piroot01/DFC77_NTP/documentation/main.tex

\documentclass[12pt]{report}
\usepackage[utf8]{inputenc}
\usepackage{graphicx}
\graphicspath{ {images/} }
\usepackage[a4paper,width=150mm,top=25mm,bottom=25mm]{geometry}
\usepackage{fancyhdr}
\usepackage{titlesec}
\usepackage{amsmath}
\usepackage{listings}

\usepackage[sorting=none,backend=bibtex]{biblatex}
\bibliography{biblio.bib}

\titleformat{\chapter}[block]{\bfseries\Huge}{}{0em}{}
\titleformat{\section}[hang]{\bfseries\Large}{}{1em}{\thesection\enspace}

\pagestyle{fancy}
\fancyhf{}
\fancyhead[R]{DCF77 NTP server}
\fancyhead[L]{\thechapter. Kapitola}
\fancyfoot[C]{\textbf{\thepage}}
\fancypagestyle{plain}{%  the preset of fancyhdr
    \fancyhf{} % clear all header and footer fields
    \fancyfoot[C]{\textbf{\thepage}} % except the center
    \renewcommand{\headrulewidth}{0pt}
    \renewcommand{\footrulewidth}{0pt}}

\title{DCF77 NTP server}

\author{Macháček Tomáš}

\date{\today}

\renewcommand*\contentsname{Obsah}

\begin{document}

\input{titlepage}

\input{affirmation}

\tableofcontents

\chapter{Abstrakt}
\input{abstract}

\chapter{Návrh antény}
\input{chapters/chapter01}

\chapter{Řidicí jednotka antény}
\input{chapters/chapter02}

\chapter{Hlavní jednotka}
\input{chapters/chapter03}

\chapter{Nasazení a obsluha}
\input{chapters/chapter04}

\chapter{Závěr}
\input{conclusion.tex}

\newpage

\chapter{Reference}

\makeatletter
\renewcommand{\chapter}{\@gobbletwo}
\makeatother

\printbibliography

\end{document}
