piroot01/DFC77_NTP/documentation/titlepage.tex

\begin{titlepage}
    \begin{center}
        \vspace*{.06\textheight}

        \LARGE

        \textsc{Gymnázium Jana Keplera}

        \vspace{1.5cm}

        \Large

        \textsc{Závěrečná práce\\
        informatika}

        \vspace{1.5cm}

        \hrule

        \vspace{0.8cm}

        \LARGE
        \textbf{DCF77 NTP server}

        \vspace{0.2cm}
        \Large
        \emph{server poskytující přesný čas}

        \vspace{0.8cm}

        \hrule
        \vspace{2cm}

        \begin{minipage}[c]{0.4\textwidth}
            \begin{flushleft} \large
                \emph{Autor:}\\
                \textsc{Macháček Tomáš}
            \end{flushleft}
        \end{minipage}
        \begin{minipage}[c]{0.4\textwidth}
            \begin{flushright} \large
                \emph{Vedoucí práce:} \\
                \textsc{Bc. Emil Miler}
            \end{flushright}
        \end{minipage}

        \vspace{8cm}

        \today

        \vfill

    \end{center}
\end{titlepage}
