piroot01/DFC77_NTP/documentation/affirmation.tex

\clearpage
\thispagestyle{empty}

\vspace*{\fill}

Prohlašuji, že jsem tuto práci vypracoval samostatně a výhradně s použitím
citovaných pramenů, literatury a dalších odborných zdrojů.

\vspace{0.2cm}

Beru na vědomí, že se na moji práci vztahují práva a povinnosti vyplývající ze
zákona č. 121/2000 Sb., autorského zákona, v platném znění.

\vspace{1.5cm}

\begin{minipage}[t]{0.4\textwidth}
    \begin{flushleft}
        \emph{Dne:}\\
        \vspace{0.5cm}
        \rule[0.5em]{10em}{0.5pt}
    \end{flushleft}
\end{minipage}
\begin{minipage}[t]{0.5\textwidth}
    \begin{flushright}
        \emph{Podpis:} \\
        \vspace{0.5cm}
        \rule[0.5em]{10em}{0.5pt}
    \end{flushright}
\end{minipage}

\vspace{1cm}
