piroot01/DFC77_NTP/codes/hardware/antenna_design/program_outputs/Inductance_to_number_of_threads.pdf

25 | 30 | 35 | 40 | 45
| | Number of threads

0.075

0.100

0.125

0.150

0.175

0.200

0.225

0.250

Inductance (uH)

### Dependence of inductance on the number of threads
