piroot01/DFC77_NTP/codes/hardware/antenna_design/program_outputs/Quality_to_number_of_turns.pdf

25 | 30 | 35 | 40 | 45
| | Number of threads

1375

1400

1425

1450

1475

1500

1525

1550

Quality factor

### Dependence of quality on the number of threads
