piroot01/DFC77_NTP/codes/hardware/antenna_design/program_outputs/Res_resistance_to_number_of_threads.pdf

25 | 30 | 35 | 40 | 45
| | Number of threads

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
Resonance resistivity (kOhm)

Dependence of resonance resistance on the number of threads
