piroot01/DFC77_NTP/documentation/main.pdf

# Gymnázium Jana Keplera

## Závěrečná práce informatika

# DCF77 NTP server

## server poskytující přesný čas

### Autor: Macháček Tomáš

### Vedoucí práce: Bc. Emil Miler

## March 25, 2022

Prohlašuji, že jsem tuto práci vypracoval samostatně a výhradně s použitím citovaných pramenů, literatury a dalších odborných zdrojů.
Beru na vědomí, že se na moji práci vztahují práva a povinnosti vyplývající ze zákona č. 121/2000 Sb., autorského zákona, v platném znění.
Dne: | Podpis:

# Obsah

1 Abstrakt | 3
2 Návrh antény | 4
3 Řidicí jednotka antény | 6
4 Hlavní jednotka | 10
5 Nasazení a obsluha | 14
6 Závěr | 17
7 Reference | 18

2

# Abstrakt

Závěrečná práce pojednává o NTP serveru, který je synchronizovaný s přijímaným časem. Čas je poskytován německým vysílačem DCF77 v Mainflingenu.
První část se zabývá návrhem antény, která je schopna přijímat signál o kmitočtu 77.5 kHz.
V druhé časti práce se rozebírá demodulaci signálu a převod na průmyslovou RS-485 sběrnici. Vše je součástí tzv. anténní jednotky, která obsahuje anténu, demodulační obvod a systém kontrolující kvalitu signálu, což je jedna ze dvou hlavních komponent projektu.
Třetí část se týká hlavní jednotky, ta je zodpovědná za zpracování DCF77 signálu a hostování NTP serveru. Jádrem je Raspberry Zero 2, na které je navržený na zakázku vyrobený HAT. Také rozebírá softwarovou stránku hlavní jednotky a instalací NTP. Též komplikace vzniklé při sestavování.
Poslední pasáž se zaobírá nasazením zařízaní do provozu a posléze připojením klientů na server.

3

# Návrh antény

## 2.1 Teorie

Anténa je zařízení, které slouží k vysílání či přijímání elektromagnetického záření. Každý vodič, jímž prochází střídavý elektrický proud, je vlastně anténa. Geometrickým tvarováním vodiče a přidáváním jistých materiálů (ferity) se upravuje účinnost antény, dle vhodných parametrů.
Každá anténa má své základní parametry. Mezi hlavní patří zisk, rezonanční frekvence, šířka přijímaného pásma a vyzařovací úhel. Podle použití antény se tyto parametry mění. Avšak hlavním parametrem, který nejvíce ovlivňuje vlastnosti, je fyzický tvar antény.
Proto dělíme antény na dipólové, monopólové, složené (Yagi-Uda anténa), smyčkové, kónické a clonové. Každá kategorie představuje jiné spektrum použití. Dipólové se používají pro vysílání TV signálu. Monopólové se používají při příjmu rádiových stanic, vlnové délky řádu desítek centimetrů. Složené jsou vysoce účinné pro širokopásmový příjem, TV i rádia. Smyčkovým anténám se budeme ještě věnovat. Kónické jsou vysoce účiné při vysokých frekvencích. Clonové jsou ideální pro dlouhý dosah.

### 2.1.1 Smyčková anténa

Smyčkové antény jsou velice jednoduché a všestranné. Jejich tvar je rozmanitý, například zaujímají tvar čtvercovitý, trojúhelníkový, kruhový a elipsovitý. Kvůli jednoduchému návrhu a analýze jsou nejvíce rozšířené mezi radioamatéry. Klasifikují se dvou hlavních skupin, elektricky malé a velké. Elektricky malé antény jsou ty, jejichž celková délka (počet závitů znásobený obvodem antény) je menší než desetina vlnové délky. Velké antény svojí délkou odpovídají vlnové délce rezonanční frekvence. Nejvíce se smyčkové antény používají v pásmech dlouhých vln.
Elektricky malé smyčkové antény mají obvykle menší radiační odpor než ztrátový odpor, tedy jsou špatné zářiče, používají se výhradně na příjem signálu. Nejvíce se používají při radiovému příjmu.
Radiační odpor lze zvýšit, a tím pádem zvýšit zisk antény. Nebo prodloužit elektrickou délkou antény či použít jádro z materiálu o vysoké permeabilitě, nejčastěji ferit. Anténa, která je tvořená cívkou navinutou na feritovém jádře, se nazývá feritová smyčková anténa [1].

4

2. Kapitola | DCF77 NTP server

## 2.2 Konstrukce

Pro tento projekt byla zvolena feritová smyčková anténa. Hlavní důvody, proč byl zvolen tento typ antény je kompaktnost, velikost řádu centimetrů, a zisk při dané rezonanční frekvenci. Praktická konstrukce je též jednoduchá. Jedná se vlastně o cívku, která je navinutá na feritové tyčince. S tím úzce souvicí pořizovací cena antény, která je nízká. Nevýhodou bylo shánění feritové tyčinky.
Proto byla nejdříve pořízena tyčinka a podle ní byla vypočítána cívka. Pro výrobu cívky byl použit enamelový drát o průměru 0.2mm. Na polohu cívky, počet závitů a další parametry byl navržen program, o něm později. Cívka se nesmí na tyčce pohybovat, proto je zalitá epoxydem.
Správná funkčnost antény byla zajištěna pomocí následující sestavy. Na generátor funkcí byl připojen volný vodič. Vytvořili jsme jednoduchou anténu. Anténa byla připojena na předzesilovač a poté na osciloskop. Měněním frekvence na generátoru a sledováním úrovně napětí na výstupu zesilovače. Největší úrovně jsme dosáhli na frekveci 77.564 kHz, což je v pořádku, neboť v demodulačním obvodu je použit vysoce účinný krystalový filtr [2]

### 2.2.1 Program pro výpočet antény

Program na výpočet antény se skládá z dvou hlavních částí, kalkulace modelu antény a poté zpracování dat do grafů.
Základem je výpočet radiačního - Rr, ohmického - RL a ztrátového odporu - Rf [3].

Rr = 20π

2

( o

λ

)4
µ

2
ef fN

2

RL =

l
σπdδ

Rf = 2πfµef f

µi
µ

µ0N

2 S
Lr
| (2.1)

Kde o je účinný obvod antény, N je počet závitů cívky, d je průměr vodiče, f je rezonanční frekvence, S je účinný povrch antény a Lr je délka antény.
Pro výpočet pozice cívky na feritové tyčce byly použity Nagaokovy rovnice, které nejblíže odpovídají reálnému modelu antény.
Dále program spočítá rezonanční kondenzátor k dané anténě, jakost antény. Zde je nutno podotknout, že jakost úzce souvisí s ziskem a šířkou přijímaného pásma. Čím užší přijímané pásmo, tím vyšší zisk, avšak anténa je více náchylná na změny tlaku, teplot atd. Právě proto generuje program grafy, které vystihují závislosti a díky nímž je snažší nalézt optimální parametry pro danou anténu.
Na konec program ještě vygeneruje tabulku, v níž jsou zapsány jednotlivé konfigurace antén [4]

5

# Řidicí jednotka antény

## 3.1 Teorie

### 3.1.1 Amplitudová modulace

Amplitudová modulace, zkráceně AM, je nejjednodušší a nejstarší typ modulace. V závislosti na změně modulačního signálu se mění amplituda nosného signálu. Nosná vlna má řádově vyšší frekvenci než modulovaný signál. Fáze a frekvence se u této modulace nemění.

Matematický popis

Pokud nosnou vlnu vyjádříme jako n(t) = N sin (Ωt), kde N je amplituda a Ω je úhlová frekvence, a jednoduchý harmonický signál m(t) = M sin (ωt + ϕ), kde ϕ je fázový posun vůči nosné n(t), pak AM vznikne složením přidáním m(t) k amplitudě nosné N. Dostáváme tedy

y(t) = (N + M sin (ωt + ϕ)) sin (Ωt) | (3.1)

### 3.1.2 DCF77

Označení DCF77 se užívá pro německý dlouhovlnný rádiový vysílač a také jedinou stanici, jíž poskytuje. Nosná frekvence DCF77 je 77500 Hz. Antény stanice se nacházejí v Mainflingenu. Pravidelné a nepřetržité vysílání začalo v roce 1970 [5].

Vysílač

Vysílač má výkon 50 kW, avšak skutečný vyzářený výkon je přibližně 25 kW. K vysílání je použitá všesměrová anténa s kapacitním nástavcem, hlavní anténa je vysoká 150 m, přičemž při údržbách se používá 200 m vysoká záložní. Dosah vysílače je 1500 až 2000 km. V České republice fungoval do roku 1995 velice podobný vysílač OMA [6].

Kódování DCF77

Kódování časové informace je prováděno pulzně šířkovou modulací (základní AM), poklesem amplitudy nosné na 25 % na začátku každé sekundy. Pakliže je puls dlouhý 100ms jedná se logickou 0, 200ms dlouhý je logická 1. Aktualizace přenášené informace je prováděna každou minutu.

6

3. Kapitola | DCF77 NTP server

Přenášejí se tyto informace:

- čas platný pro následující minutu
- datum platné pro následující minutu
- číslo dne v týdnu
- hlášení změny časové zóny 1 hodinu předem (informace o přechodu ze standardního na letní čas nebo opačně)
- časová zóna (je-li aktivní CET nebo CEST)
- hlášení přestupné sekundy 1 hodinu předem
- provoz na normální a rezervní anténu
- zabezpečení přenosu – několik paritních bitů
- od roku 2007 i předpověď počasí

### 3.1.3 RS-485 komunikace

Jedná se o typ komunikace, která se především používá v průmyslových prostředích. Standard 485 je navržen tak, aby umožňoval vytvoření dvouvodičového poloduplexního vícebodového sériového spojení. Vlastně se jedná o značně napěťově posílenou RS-232, což je totéž co RS-485, avšak dosah sběrnice je až 1200 m, oproti 20 m.
Komunikační linka je tvořena dvěma vodiči (označené A a B), na obou koncích jsou kvůli zvýšení odolnosti proti rušení 120Ω rezistory. Maximální přenosová rychlost je 10 Mib/s.
Přenos dat je uskutečněn pomocí 7 nebo 8bitových rámců se startbitem a poté jedním či více stopbity. Vysílač by měl na výstupu při logické 1 (klidový stav linky) generovat na vodiči A napětí −2 V, na vodiči B +2 V, při logické 0 by měl na vodiči A generovat +2 V, na vodiči B −2 V [7].

## 3.2 Zpracování anténní jednotky

Mezi hlavní požadavky anténní jednotky patřila i kompaktnost, proto byl vytvořený, na zakázku, plošný spoj, na nemž jsou uložené všechny komponenty. Dělí se na tři základní sektory, první je zodpovědný za demodulaci signálu, druhý převádí demodulovaný signál na RS-485 sběrnici a poslední vyhodnocuje jakost signálu. Každému sektoru je přiřazen jeden integrovaný obvod.

### 3.2.1 Demodulace DCF77 signálu

Pro tento účel byl zvolen U4224B integrovaný obvod. Jedná se o přijímací obvod, který disponuje demodulací od 40 do 80 kHz, podle zvoleného krystalu. Má velmi vysokou citlivost, takže i v oblatech s vysokým rušením či slabým signálem, je možně anténu dobře naladit.

7

3. Kapitola | DCF77 NTP server

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

### 3.2.2 Převod na RS-485 sběrnici

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

### 3.2.3 Systém pro vyhledávání signálu

Abychom nemuseli při ladění antény čekat dvě minutu na načtení celého bufferu a potom zjišťovali, zda je správný. Nutno podotknou, že anténa je směrová, takže záleží na směru normálového vektoru vůči zdroji, což je anténa DCF77. To ještě ztěžuje situaci ladění. Rychlejší způsob ladění vyžaduje osciloskop. Proto bylo nutné vybavit obvod zařízením, které by v reálném čase sledovalo přijímaný signál a vyhodnocovalo jeho kvalitu.

8

3. Kapitola | DCF77 NTP server

Srdcem je mikrokontrolér PIC, na který je nahraný program, který analyzuje signál z přijímače. Dále jsou na PIC připojeny dvě LED, které fungují jako signalizace. Jedna je zelená, značící, že je obvod napájen a druhá, oranžová, signalizuje kvalitu signálu. A to následujícím způsobem:

Pokud dioda nesvítí, potom je signál zcela vadný. Jakmile se dioda rozbliká, znamená to, že byl přijat validní bit, pakliže se dioda rozbliká rychleji (s vyšší frekvencí), byl přijat další validní bit. Tento postup pokračuje, až dioda svítí, neboli anténa je naladěná. S klesající frekvencí se naopak anténa rozlaďuje. Svitící dioda je zárukou dobrého signálu, nikoliv však dostatečně silného signálu, který je vyžadován NTP.

Program funguje tak, že kontroluje správnou délku signálu, frekvenci, intervaly mezi jednotlivými pulsy, inverzní délku pulzů a minutový puls (prázdný). Pakliže všechny parametry jsou splněny, je bit zaznamenán jako korektní. Tuto proceduru provádí s každým bitem, a to v reálném čase, takže uživatel má aktuální přehled o kvalitě přijímaného signálu a může nalézt místo s nejlepším příjmem.
Deska je osazená pinovou lištou, která slouží k flashování programu, takže je velice snadné aktualizovat program v PICu.

9

# Hlavní jednotka

## 4.1 Teorie

### 4.1.1 Network time protocol

NTP je protokol pro synchronizaci vnitřních hodin počítačů po paketové síti s proměnným zpožděním. Tento protokol zajišťuje, aby všechny počítače v síti měly stejný a přesný čas. Byl obzvláště navržen tak, aby odolával následku proměnlivého zpoždění v doručování paketů.
Počítač, který chce synchronizovat své hodiny, pošle pár dotazů několika NTP serverům a ty mu v odpovědi pošlou svůj, přesný čas. Klient z odpovědí nejprve vyloučí servery se zřejmě nesmyslným časem (s odchylkou 1000 sekund a více). Poté ponechá skupinu serverů s největším společným průnikem.
NTP je jeden z nejstarších dosud používaných IP protokolů. NTP původně navrhl Dave Mills z univerzity v Delaware a stále jej, spolu se skupinou dobrovolníků, udržuje. Současná verze je NTP verze 4, kterou popisuje RFC 5905.
NTP démon je uživatelský proces, který na stroji běží trvale. Většina protokolu a inteligence je implementována v tomto procesu. Pro dosažení nejlepšího výkonu je důležité, aby jádro operačního systému umělo řídit čas fázovým závěsem, místo aby přesný čas do systémových hodin dosazoval NTP démon přímo. Všechny dnešní verze Linuxu fázový závěs implementují.
NTP používá hierarchický systém „strata hodin“, kde systémy se stratem 1 jsou synchronizovány s přesnými externími hodinami jako třeba GPS nebo jiné hodiny řízené rádiovým signálem (v Česku obvykle DCF77). NTP systémy strata 2 odvozují svůj čas od jednoho nebo více systémů se stratem 1 atd. To zabraňuje vzniku cyklu v grafu synchronizujících se strojů. Stratum systému leží v rozsahu 1 až 14; stratum 0 mají samotné referenční hodiny připojené k nejpřesnějšímu serveru; stratum 15 má počítač, který se v důsledku výpadku sítě nemůže synchronizovat se zdrojem času, nebo se synchronizuje po výpadku spojení [8].

## 4.2 Hardware

V této části se budeme zabývat hardwarovou stránkou hlavní jednotky. Bylo nutné vyřešit dvě záležitosti; za prvé jakou platformu zvolit pro běh NTP serveru a za druhé jak konvertovat zpět RS-485 signál. Jelikož provoz NTP serveru neni hardwarově náročný, bylo zvoleno Raspberry ZERO 2. To přineslo řadu výhod, okamžitě se vyřešil druhý problém, všechny přídavné obvody budou součástí tzv. HATu. Navíc je celá sestava velice kompaktní.

10

4. Kapitola | DCF77 NTP server

### 4.2.1 RPi HAT

HAT je označení pro PCB, které je namontováno na, v našem případě, jednodeskový počítač. Rozšiřuje funkčnost desky, přidává vlastnosti. Raspberry disponují 2x20 pinovou lištou, GPIO, která je vhodná pro komunikaci s HATem. Rozměry HATu jsou shodné s Raspberry. A je to z toho důvodu, aby byl HAT pomocí sloupků spojen s raspberry, a tím bylo zajištěno pevné spojení desek.
Hlavní funkce HATu, má za úkol převádět RS-485 komunikaci zpět na TTL logickou úroveň. Potom byl na desku ještě přidán ethernetový převodník. Iniciálně se totiž plánovalo použít raspberry zero, to se neuskutečnilo, více bude řečeno později.

Komunikace s anténou

Je použito naprosto stejné zapojení jako na řidicí jednotce antény, to znamená i stejný integrovaný obvod. Ten je zapojený v režimu receiver. Výstup je zaveden na UART na headeru raspberry.

Zprovoznění UART komunikace

Při zprovozňování serveru vyvstal problém. Na samé piny (10 a 12) je připojena sběrnice bluetooth. A přitom raspberry má několik UART zařízení, konkrétně AMA0, USB0 a S0. Pro naše účely je vhodné pouze AMA0, jelikož jako jediný disponuje nezávislým UART převodníkem, mimo CPU. Ostatní jsou závislé na aktuální taktovací frekvenci CPU, která se mění, a to je nežádoucí u přesného vyčítání dat.
Takže jako první se deaktivoval kompletně bluetooth, přes raspi-config. Ve stejném prostředí byl povolen AMA0 serial port.

/ boot / c o n f i g . txt

[ a l l ]

enable_uart=1
dtoverlay=d is a bl e −bt

Poté byla ověřena komunikace pomocí # screen /dev/ttyAMA0 9600. Na konzoli by se měly zobrazovat znaky (jedno jaké) s vteřinovou periodou.

11

4. Kapitola | DCF77 NTP server

### 4.2.2 Zprovoznění DCF77 jako stratum 1 NTP serveru

Potom, co byla zajištěno funkční vyčítání dat z anténý správným UART rozhraním, se můžeme přesunout na samotnou instalaci NTP serveru [9].

Instalace s podporou RAW DCF

Prvním krokem je nainstaloování NTP, avšak pro naše účely je nutná podpora DCF77. Instalaci provedeme dle následujících kroků.

$ wget http ://www. e e c i s . udel . edu/~ntp/ ntp_spool /
ntp4 /ntp −4.2/ ntp −4.2.8 p15 . tar . gz
$ tar zxf ntp −4.2.8 p15 . tar . gz
$ cd ntp −4.2.8 p15/
$ . / c o n f i g u r e −−enable−RAWDCF −−p r e f i x =/usr $ make
$ sudo systemct l stop ntp . s e r v i c e
$ sudo make i n s t a l l :
$ echo ” ntp hold ” | sudo dpkg −−set −s e l e c t i o n s

Poslední příkaz slouží k zakázání aktualizací NTP. Verzi NTP ověříme přes ntpq --version.

Nastavení strata 1

Ješte před tím, než nastavíme referenční hodiny pro NTP, přidáme uživatele user do skupiny tty.

$ sudo adduser user tty
$ cat / etc / group | grep tty

Nyní zeditujeme wrapper kód NTP, tak, aby server užíval DCF jako zdroj stratum 1. Referenční hodiny /dev/refclock-0 jsou systémovým linkem na /dev/ttyAMA0.

#f o r using the DCF77 r e c e i v e r add t h i s

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

#commented out t h i s

#i f [ −e /run/ntp . conf . dhcp ] ; then

| #NTPD_OPTS=”$NTPD_OPTS −c /run/ntp . conf . dhcp”
#f i

12

4. Kapitola | DCF77 NTP server

Nastartujeme daemon sudo systemctl start ntp.service. Můžeme zkontolovat přítomnost symbolického linku.

$ l s −ahl /dev/ r e f ∗
/dev/ r e f c l o c k −0 −> /dev/ttyAMA0

Dále upravíme soubor /etc/ntp.conf.

ntp . conf

Konečně restartujeme NTP daemon a zkontrolujeme aktivitu NTP serveru, a to přes ntpq -p. Správný příjem lze jednoduše ověřit tak, že hodnota reach je 377.

Oprava časové diletace = fudgetime

Díky nedokonalosti přenosu a časovým prodlevám vzniklé konverzí, je záhodné nastavit kompenzační časovou konstantu, která bude vyrovnávat časový schodek. Celkový fudgetime je dán součtem předkonfigurovaným a reálného, ten je v našem případě 592 ms. Předkonfigurovaný fudgetime zjistíme následovně (zde 292 ms).

$ ntpq −c cv
. . . fudgetime1 =292.000 ,

### 4.2.3 Ethernetové připojení a USB-C napájení

Tyto dva hardwarové prvky se nepodařilo zprovoznit. Ethernet konektor slouží k navázání stabilního připojení. Problém spočíval v tom, že jsem zapomněl připojit jednu nožičku integrovaného obvodu ethernetového převodníku na +3.3V, jednalo se o napájení TX. Bypass se povedl, obvod fungoval bez problémů. Avšak kvůli veliké křehkosti a nestabilnosti spoje byl čip odpájen a změněn návrh plošného spoje, který jsem nestihl znovu poptat.
S napájecím konektorem byl nenapravitelný problém. Vlastně hlavní význam integrovat napájecí konektor na desku byla špatná orientace napájecího konektoru na RPi. A navíc USB-C napájení je v dnešní době nejuniverzálnější konektor. Problém spočíval v špatném footprintu. Vyřešil jsem to tak, že se na napájecí linky RPi byly napájeny vodiče, které se přivedly na USB mini konektor, je robustnější než micro.

13

# Nasazení a obsluha

V závěrečné kapitole si podrobně popíšeme, jak zažízení nasadit. V podstatě, co s zařízením dělat, když se nám dostane do rukou.

## 5.1 Nasazení zařízení na lokální síť

### 1. Připojení

Jako první musíme zažízení, resp. hlavní jednotku, připojit k lokální síti. Provedeme to headless způsobem, takže první vyjmeme SD kartu z RPi. K SD kartě se dostaneme tak, že povolíme dva krajní M3 šrouby na zadní straně hlavní jednotky. Vysuneme opatrně uvolněný obal. Nikoliv se nesnažíme oddělit dvě části úplně, postačí jenom odklopit odšroubovanou část a uvidíme RPi navrchu. Poté vytáhneme SD kartu, možná budou překážet šrouby - odstraňte je proto zcela.
Vsuneme SD kartu do počítače a vytvoříme soubor (pokud již existuje, pak editujeme) /etc/wpa_supplicant/wpa_supplicant.conf a do něj zapíšeme.

network={
s s i d =”SSID”
psk=”password ”
key_mgmt=WPA−PSK
}
Poté vrátíme SD kartu do zařízení přiklopíme obal, zašroubujeme, dbáme, abychom neskříply žádné vodiče. Zapojíme zařízení na napájení. Abychom zjistili, jakou adresu má zařízení můžeme použít například nmap -n 192.168.0.0/24. Zařízení bude mít pravděpodobně jako jedniné otevřený jenom ssh port. Poté se jednoduše připojíme přes ssh jako uživatel ntpcli ssh ntpcli@192.168.X.X. Heslo je ntp. A nebo se zkusíme připojit přes ssh ntpcli@raspberrypi.local.

14

5. Kapitola | DCF77 NTP server

### 2. Status antény

Nyní se zaměříme na NTP server. Jako první ověříme, že je nastartovaný NTP daemon.

$ sudo systemct l s t a t u s ntp
# password f o r sudo i s ntp

$ s t a t u s
Poslední příkaz používáme k zjištění stavu, ten by měl iniciálně vypadat takto

ntpcli@raspberrypi :~ $ status
associd=0 status=0000 no events , clk_unspec ,
device=”RAW DCF77 CODE ( TimeBrick )” , timecode=””, poll =3, noreply=0, badformat=0, baddata=0, fudgetime1 =877.000 , stratum=0, r e f i d=DCFa,
f l a g s =0, refclock_time=”<UNDEFINED>”, refclock_status =””,
refclock_format=”RAW DCF77 Timecode” ,
refclock_states=”∗NOMINAL: 00:02:48 (100.00%); running time : 00:02:48”
a když je přijímán korektní signál a je správně dekódován (obvykle do tří minut po zapnutí - záleží na kvalitě signálu), potom takto:

ntpcli@raspberrypi :~ $ status
associd=0 status=0020 2 events , clk_unspec ,
device=”RAW DCF77 CODE ( TimeBrick )” , timecode=”−−#−−##−−−#−−−−−−−M−S12−−1−−P12−−−2P−−4−−2−−412−−−−2−−−2−−P” , poll =8, noreply=0, badformat=2, baddata=0, fudgetime1 =877.000 , stratum=0, r e f i d=DCFa, f l a g s =0,
refclock_time=”e5e76b81 .00000000 Thu, Mar 24 2022 22:13:21.000” , refclock_status=”TIME CODE; (LEAP INDICATION; CALLBIT)” ,
refclock_format=”RAW DCF77 Timecode” ,
Pokud trvá načtení správného bufferu dlouho, tak je slabý signál, což status antény neobjeví. Buď lze počkat, NTP server nevyžaduje synchronizaci každou minutu, postačí bohatě jedna synchronizace za 12 hodin, a nebo vyhledat místo s lepším příjmem.
Pokud chceme vidět aktuální dekódovaný čas, můžeme využít funkci t, na konzoli, jedná se o předvytvořený alias. Ta spustí watch se sekundovou aktualizací. Vidíme-li Error 666: Check NTP status., znamená to, že hodiny nepřijímají. Pakliže se objeví aktuální čas, podařilo se dekódovat načíst buffer pro probíhající minutu.

### 3. Nastavení na lokální síť

Tato část se převážne věnuje konfiguračnímu souboru NTP, /etc/ntp.conf. Znamenaje, že nastavíme jací uživatelé budou mít přístup k času NTP serveru, resp. subnet. To provedeme editací 53 řádku konfiguračního souboru.
r e s t r i c t 1 0 . 4 2 . 0 . 0 mask 2 5 5 . 2 5 5 . 0 . 0 notrap nomodify
Na tomto příkladu vidéme, že k času budou mít přístup uživatelé pouze subnetu 10.42.0.0 (například uživatel 10.42.6.9 bude mít přístup). A na konec editujeme řádek 58, který říká jakým uživatelúm má NTP server vysílat.
broadcast 1 0 . 4 2 . 2 5 5 . 2 5 5
To je vše, co se týká konfigurace NTP serveru.

15

5. Kapitola | DCF77 NTP server

## 5.2 Nastavení klienta - chrony

Tato část je pouze dodatkem pro uživatele operačního systému Linux. Postačí do konfiguračního souboru chrony /etc/chrony.conf přidat:
s e r v e r 1 0 . 4 2 . 0 . 1 i b u r s t
Kde 10.42.0.1 je adresa NTP serveru [10].

16

# Závěr

Tento projekt měl za cíl zjistit a dokázat, že za kvalitní NTP server, který je řízený rádiově, nemusíme utrácet desítky tisíc korun. Komerční řešení téhož se prodává okolo 16000 Kč, viz Meinberg NTP servers.
Další cíle, které se podařilo při jeho kompletaci splnit, je kompaktnost a jednoduchost. Zapojení zařízení vyžaduje pouze napájení a propojení s anténou, toť vše. Také bylo dbáno, aby bylo pokud možno všechno ochráněno, zejména proti elektrickým jevům. Zároveň bylo myšleno i na pořizovací náklady zařízení, cena se s rezervou vejde do 1500 Kč.
Při realizaci se samozřejmě objevily i komplikace. Největší z nich, která zároveň vyžadovala nejvíce úsilí, byl špatně navržený plošný spoj. To znamená, že oprava by vyžadovala kompletní přepracování HATu. To způsobilo, že nefunguje ethernet konektor. Minoritní záležitost, která je způsoben požadavkem vertikálního SMD USB C konektoru, který není běžný a je velice obtížné jej sehnat. Náhradou se stal mini USB konektor, micro nebyl zvolen kvůli konstrukční pevnosti. Bohůžel se při instalaci nenávratně poníčil OLED displej, jeho náhrada nebyla realizována. Nicméně je, dle mého názoru, projekt úspěšný.

17

# Reference

[1] Constantine A. Balanis. Antenna theory, analysis and design. Ed. by Arizona university. 2nd ed. John Wiley & Sons, 1997.
[2] S. W. Lee. Antenna handbook. Ed. by Y. To. Lo. 3rd ed. Van Nostrad Reinhold, 1993.
[3] V. G. Welsby. The theory and design of inductance coils. Ed. by W. G. Radley. 1st ed. MACDONALD & Co., 1950.
[4] Peter Vizmuller. RF Design Guide. Ed. by circuits Systems and equations. 2nd ed. Artek House, 1954.
[5] Wikipedie. DCF77. Accessed on 2022-25-03. 2022. url: https://en.wikipedia.org/wiki/DCF77.
[6] Physikalisch-Technische Bundesanstalt. Accessed on 2022-25-03. 2019. url: https://www.ptb.de/cms/en/ptb/fachabteilungen/abt4/fb-44/ag-442/dissemination-of-legal-time/dcf77.html.
[7] Wikipedie. RS-485 serial bus. Accessed on 2022-25-03. 2022. url: https : //en.wikipedia.org/wiki/RS-485.
[8] GNU free document. Network Time Protocol daemon - archlinux wiki. Accessed on 2022-25-03. 2022. url: https://wiki.archlinux.org/title/Network_Time_Protocol_daemon.
[9] Andy Shinton. NTP: The Network Time Protocol. Accessed on 2022-25-03. 2020. url: https://www.ntp.org.
[10] GNU free document. Chrony - archlinux wiki. Accessed on 2022-25-03. 2021. url: https://wiki.archlinux.org/title/Chrony.

18
