piroot01/DFC77_NTP/3D_files/antenna_case/3MF/Rod_holder_a.3mf

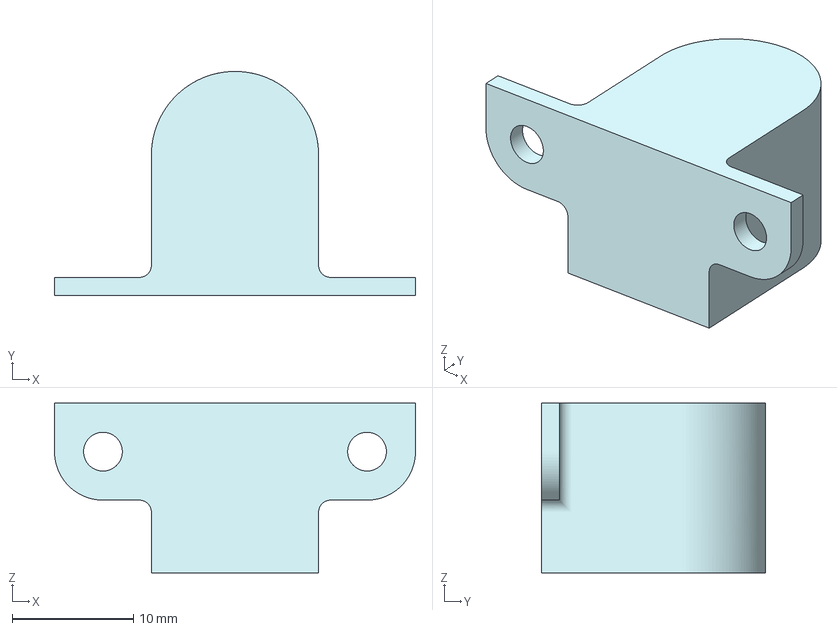
[picture p1: CAD file, 2022-01-04]
3D_files/antenna_case/3MF/Rod_holder_a.3mf
29.8 x 18.5 x 14.0 mm
