piroot01/DFC77_NTP/3D_files/antenna_case/STEP/Antenna_case.step

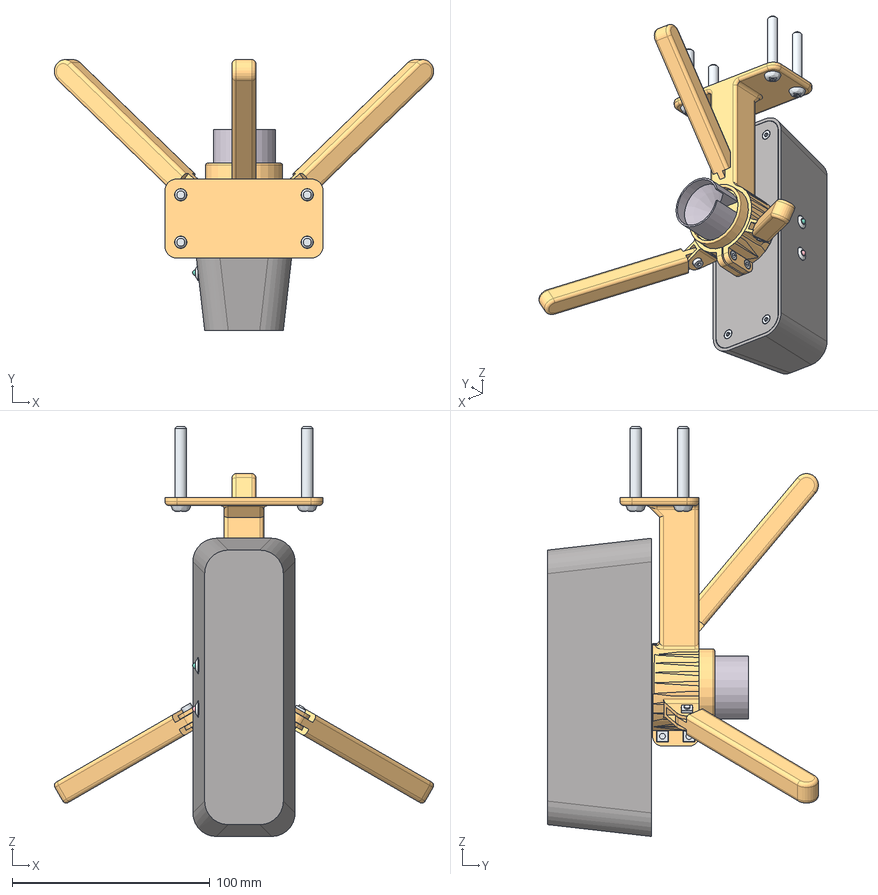
[picture p2: CAD file, 2022-01-04]
3D_files/antenna_case/STEP/Antenna_case.step
191.9 x 137.0 x 207.4 mm
RJ45_connector
Red_indicator
Green_indicator
