piroot01/DFC77_NTP/3D_files/antenna_case/3MF/Spool_holder.3mf

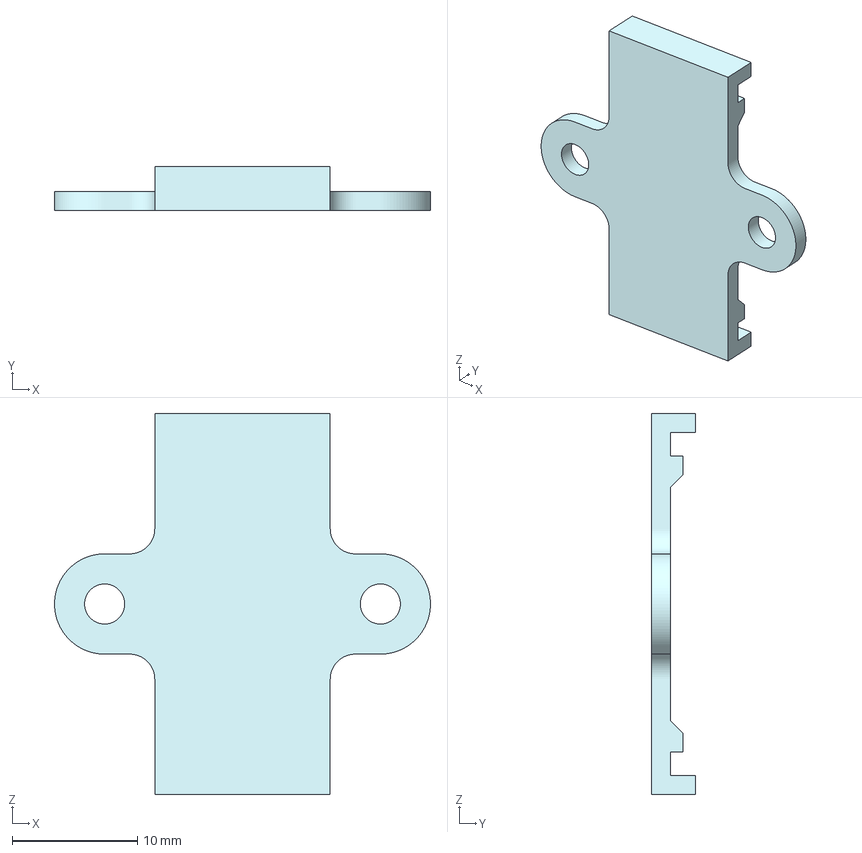
[picture p3: CAD file, 2022-01-04]
3D_files/antenna_case/3MF/Spool_holder.3mf
30.0 x 3.50 x 30.4 mm
