piroot01/DFC77_NTP/3D_files/antenna_case/3MF/Key.3mf

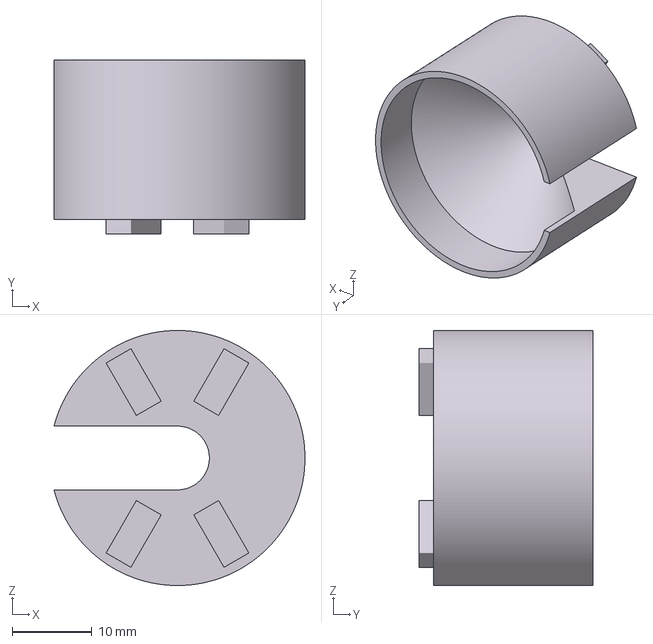
[picture p4: CAD file, 2022-01-04]
3D_files/antenna_case/3MF/Key.3mf
31.5 x 21.8 x 32.0 mm
