piroot01/DFC77_NTP/3D_files/main_unit_case/3MF/Case_second_part.3mf

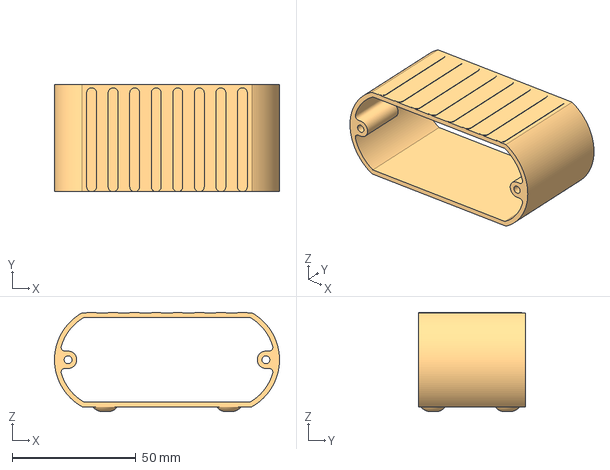
[picture p5: CAD file, 2022-03-21]
3D_files/main_unit_case/3MF/Case_second_part.3mf
91.0 x 43.5 x 40.2 mm
