piroot01/DFC77_NTP/3D_files/antenna_case/3MF/Spool_a.3mf

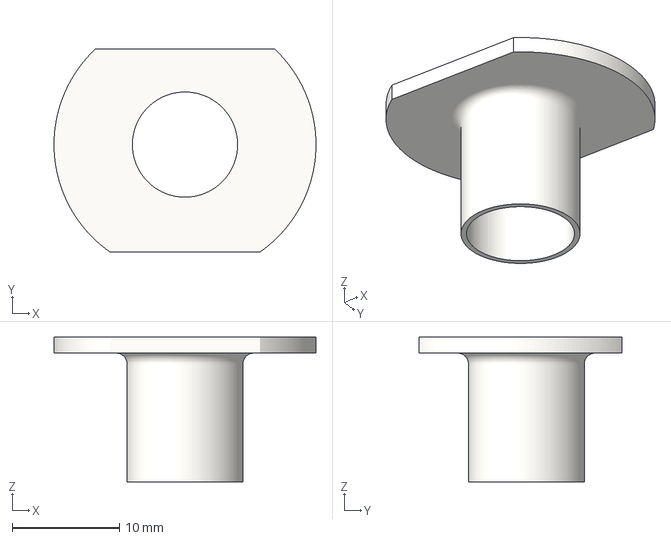
[picture p6: CAD file, 2022-01-04]
3D_files/antenna_case/3MF/Spool_a.3mf
24.4 x 18.9 x 13.5 mm
