piroot01/DFC77_NTP/3D_files/main_unit_case/3MF/Case_third_part.3mf

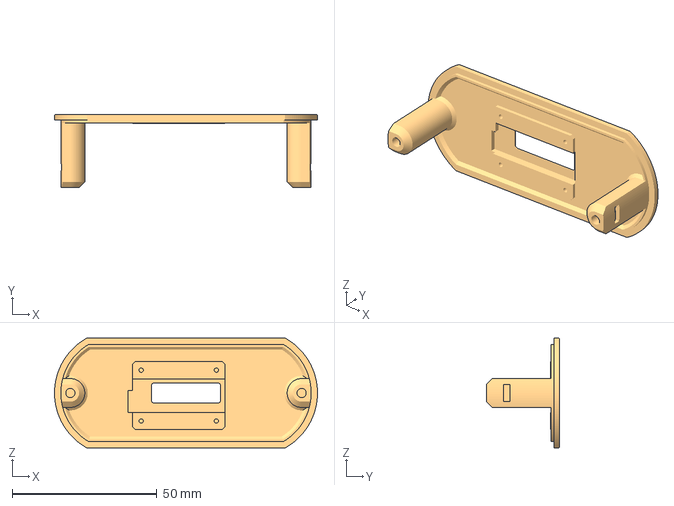
[picture p7: CAD file, 2022-03-21]
3D_files/main_unit_case/3MF/Case_third_part.3mf
91.0 x 25.4 x 38.0 mm
