piroot01/DFC77_NTP/3D_files/antenna_case/3MF/Leg.3mf

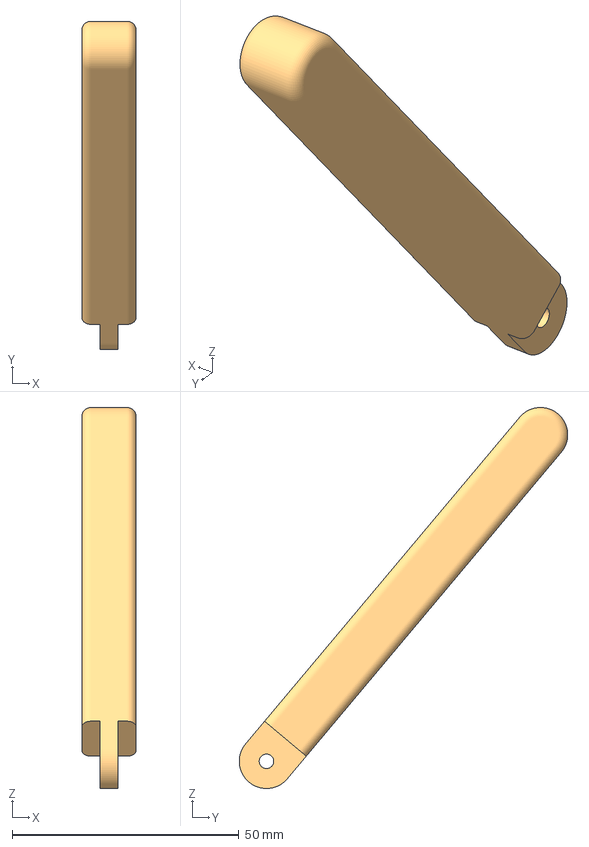
[picture p8: CAD file, 2022-01-04]
3D_files/antenna_case/3MF/Leg.3mf
12.0 x 72.4 x 84.0 mm
