piroot01/DFC77_NTP/3D_files/main_unit_case/3MF/Case_first_part.3mf

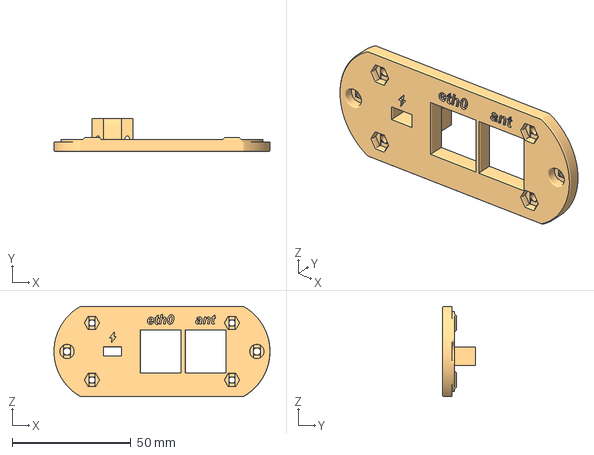
[picture p9: CAD file, 2022-03-21]
3D_files/main_unit_case/3MF/Case_first_part.3mf
91.0 x 14.0 x 38.0 mm
