piroot01/DFC77_NTP/3D_files/antenna_case/3MF/Collar_holder.3mf

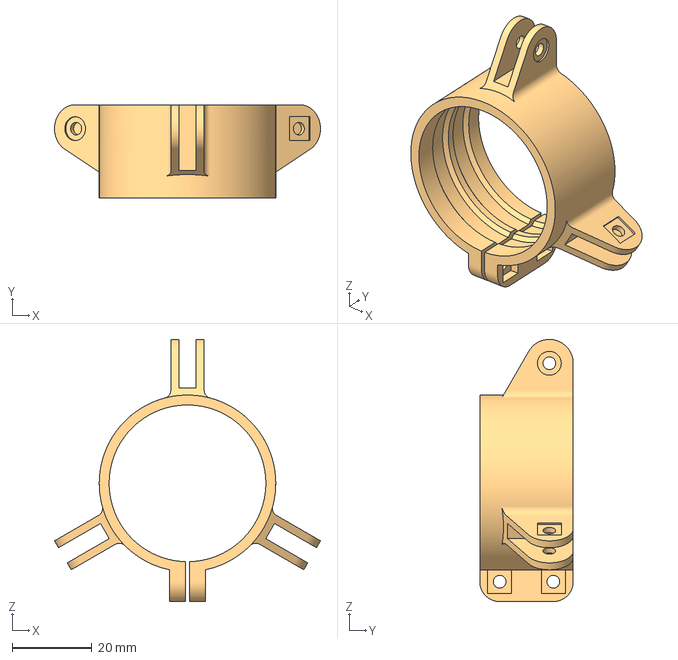
[picture p10: CAD file, 2022-01-04]
3D_files/antenna_case/3MF/Collar_holder.3mf
66.9 x 23.5 x 65.9 mm
