piroot01/DFC77_NTP/3D_files/antenna_case/3MF/Shell.3mf

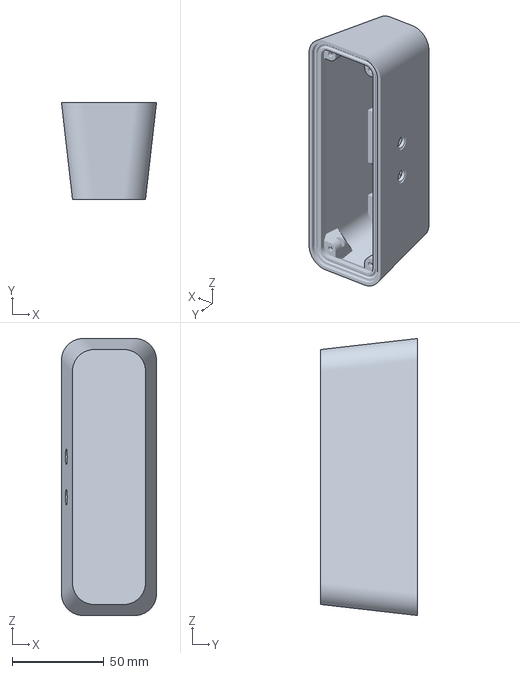
[picture p11: CAD file, 2022-01-04]
3D_files/antenna_case/3MF/Shell.3mf
51.8 x 52.6 x 150.9 mm
