piroot01/DFC77_NTP/3D_files/antenna_case/3MF/Collar.3mf

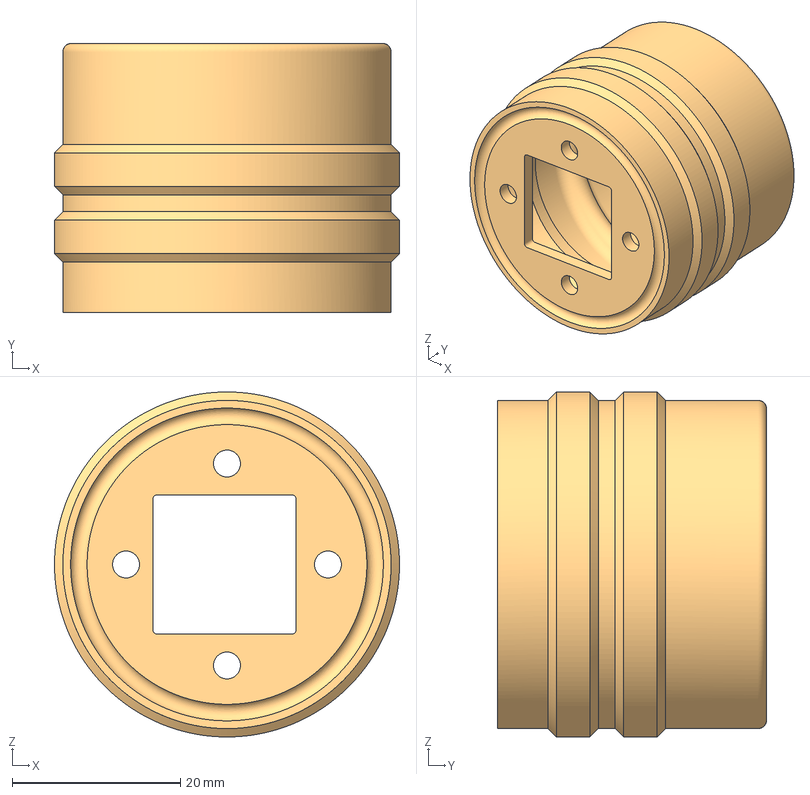
[picture p12: CAD file, 2022-01-04]
3D_files/antenna_case/3MF/Collar.3mf
41.0 x 32.0 x 41.0 mm
