piroot01/DFC77_NTP/3D_files/antenna_case/3MF/Cap.3mf

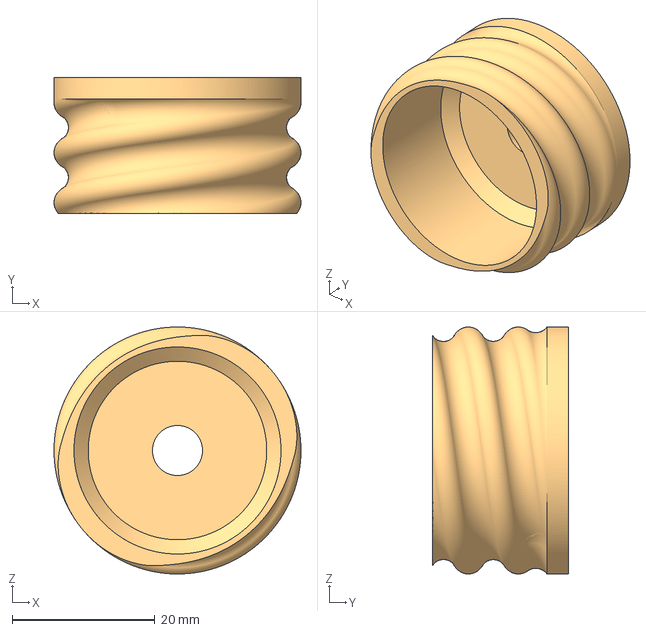
[picture p13: CAD file, 2022-01-04]
3D_files/antenna_case/3MF/Cap.3mf
34.6 x 19.0 x 34.6 mm
