piroot01/DFC77_NTP/3D_files/antenna_case/3MF/Cover.3mf

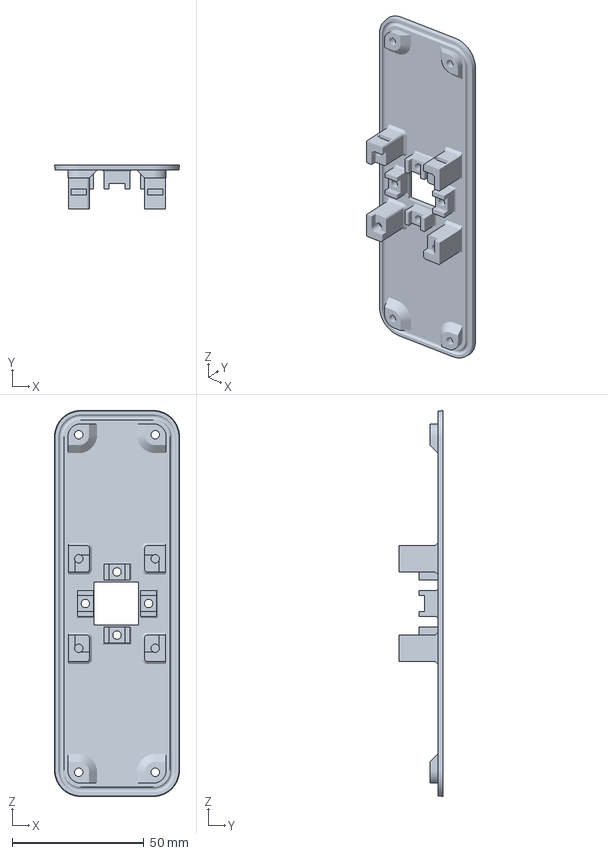
[picture p14: CAD file, 2022-01-04]
3D_files/antenna_case/3MF/Cover.3mf
47.5 x 16.8 x 146.6 mm
