piroot01/DFC77_NTP/(list of files, cad)

Other CAD files:
3D_files/main_unit_case/3MF/USB_connector_part.3mf
3D_files/main_unit_case/3MF/LCD_support.3mf
3D_files/antenna_case/3MF/Rod_holder_b.3mf
3D_files/antenna_case/3MF/Spool_b.3mf
3D_files/antenna_case/3MF/Collar_holder (1).3mf
