piroot01/DFC77_NTP/pcb_files/main_unit/Schematic.PDF

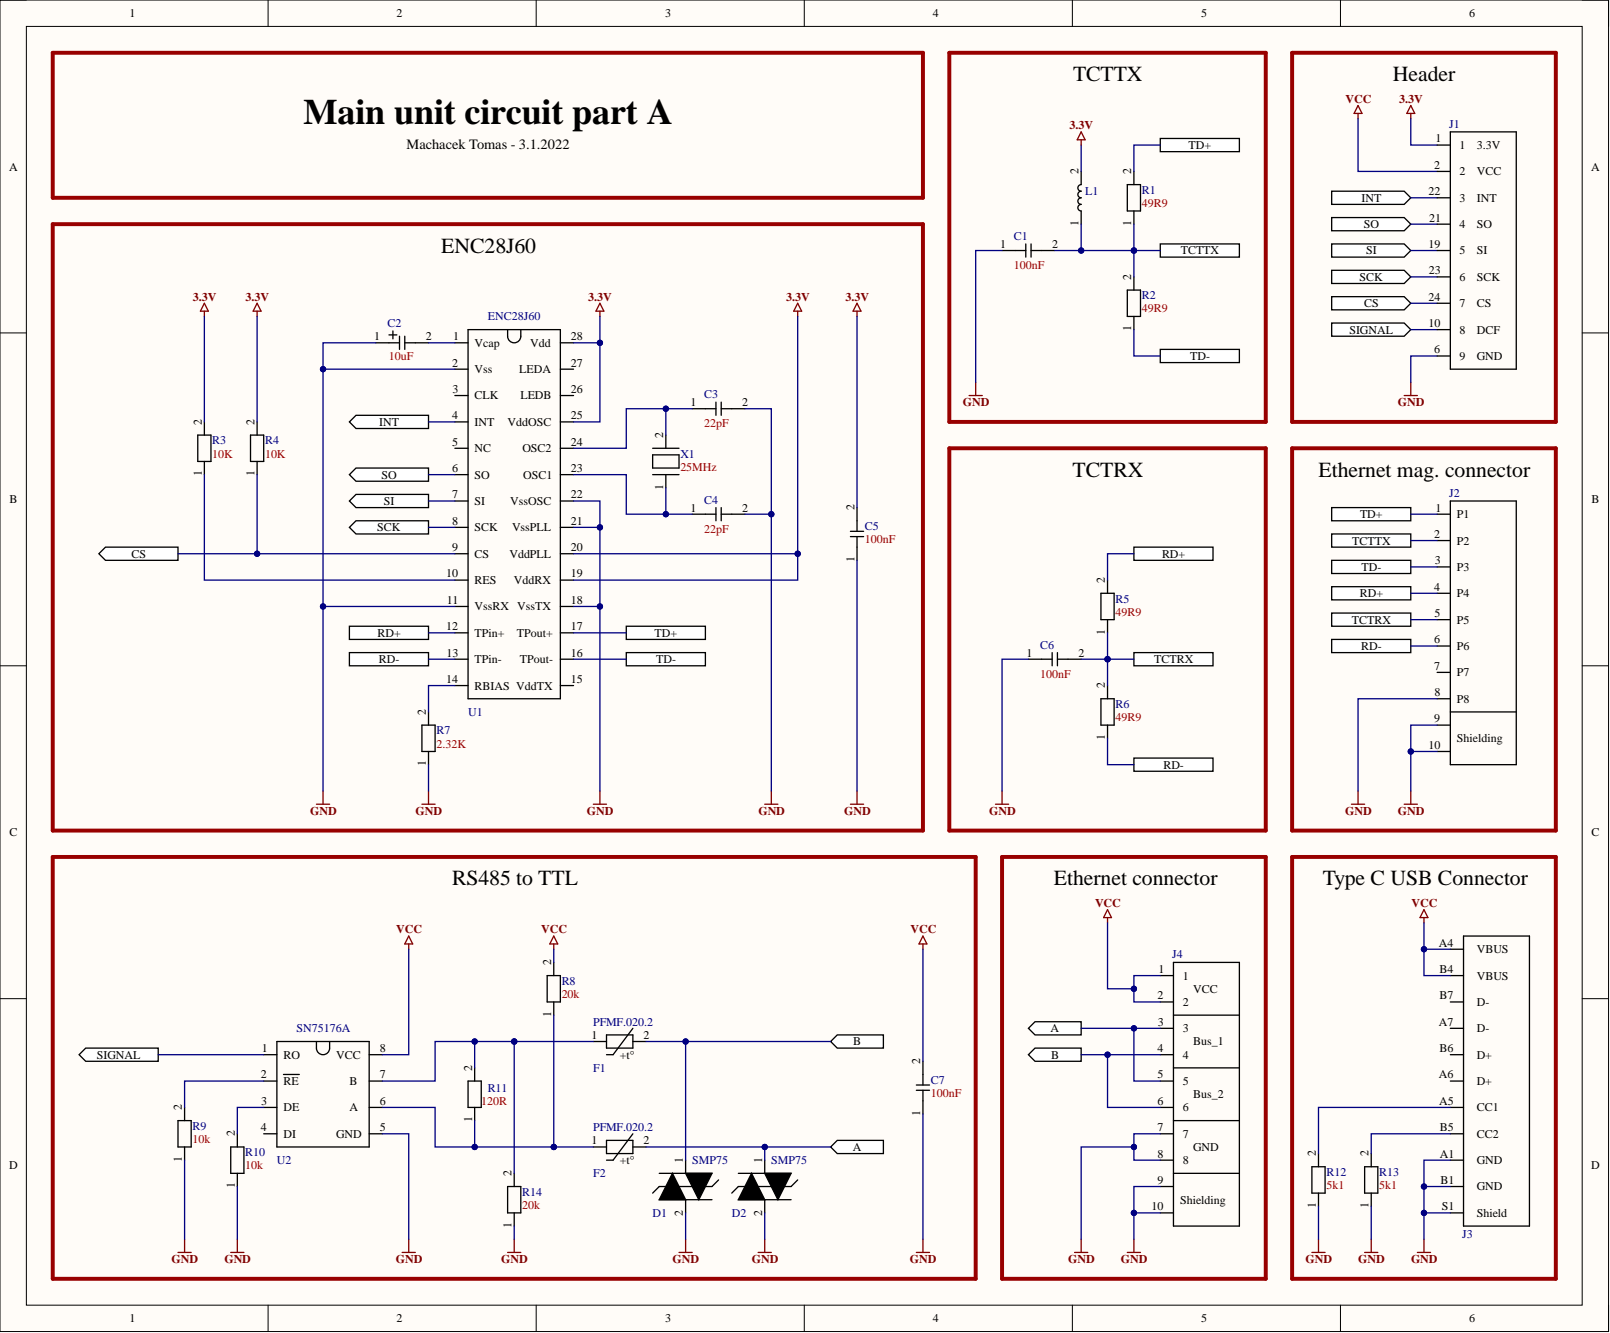
[picture p15: page 1]

Main unit circuit part A

INT SO | 3
