piroot01/DFC77_NTP/pcb_files/antenna/Schematic.PDF

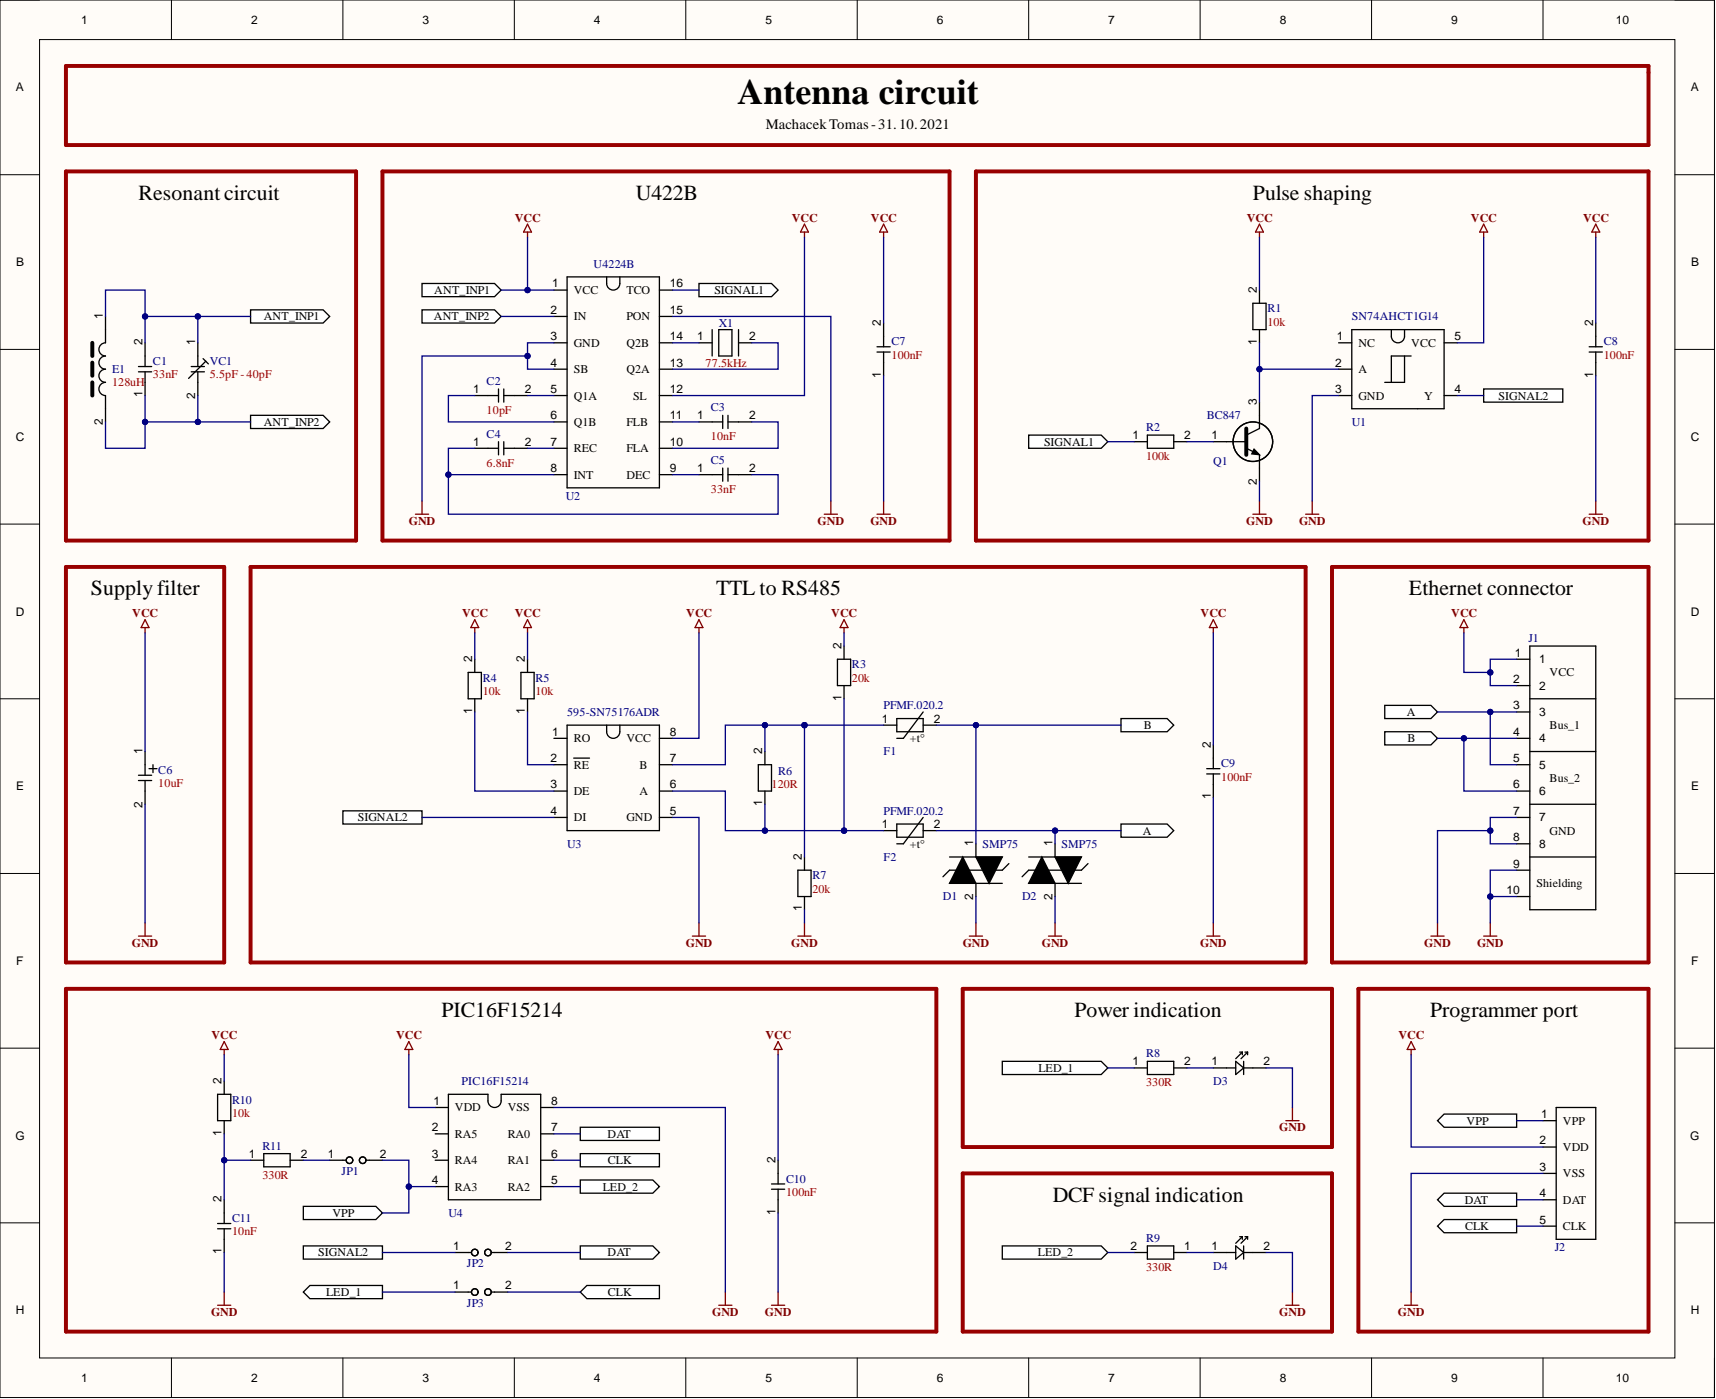
[picture p16: page 1]

3 | 6 | | R6
