piroot01/DFC77_NTP/(list of files, drawings)

Other design files:
pcb_files/antenna/PCB.PcbDoc
pcb_files/antenna/Schematic.SchDoc
pcb_files/main_unit/PCB.PcbDoc
pcb_files/main_unit/Schematic.SchDoc
