piroot01/DFC77_NTP/(commit log)

2022-01-04 antenna_signal_status: initial upload
2022-01-04 antenna_signal_status: app.h
2022-01-04 antenna_signal_status: mcc_generated_files
2022-01-04 3D_files: antenna case
    [Antenna_case.step, Cap.3mf, Collar.3mf, Collar_holder (1).3mf, Collar_holder.3mf, Cover.3mf, Key.3mf, Leg.3mf]
2022-01-09 pcb_files: antenna
    [Main.SchDoc, PCB1.PcbDoc]
2022-01-09 pcb_files: gerber
2022-01-09 pcb_files: main_unit
    [Main.SchDoc, PCB1.PcbDoc]
2022-01-22 pcb_files: file naming
    [PCB.PcbDoc, Schematic.SchDoc]
